bluerobotics/lumen/Lumen-Driver-X2.brd

## EAGLE design Lumen-Driver-X2.brd (2020-04-01)

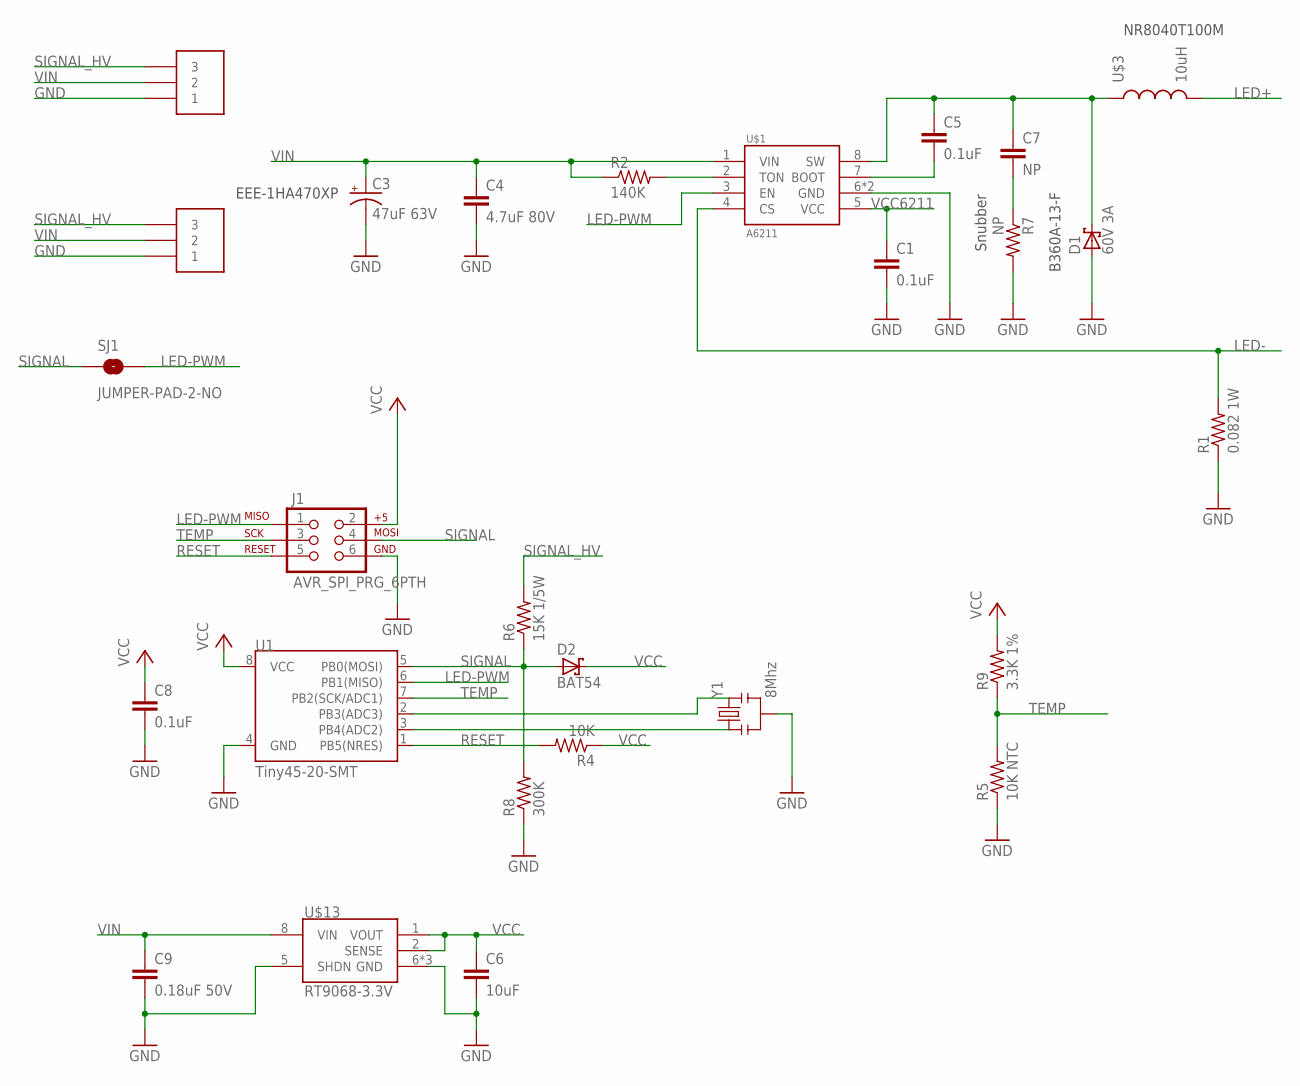
[picture p3: schematic Lumen-Driver-X2.sch]

Parts:
C1, C5, C8: 0.1uF; C0402
C3: 47uF 63V; PANASONIC_D
C4: 4.7uF 80V; C1210
C6: 10uF; C0603
C7: NP; C0603
C9: 0.18uF 50V; C0805
D1: 60V 3A; SMA
D2: BAT54; SOD523
J1: AVR_SPI_PRG_6PTH; 2X3
R1: 0.082 1W; R2512
R2: 140K; R0402
R4: 10K; R0402
R5: 10K NTC; R0603
R6: 15K 1/5W; R0402
R7: NP; R1206
R8: 300K; R0402
R9: 3.3K 1%; R0402
SJ1: JUMPER-PAD-2-NO; PAD-JUMPER-2-NO_NO_SILK
U1: Tiny45-20-SMT; SO08-EIAJ
U$1: A6211; SOIC8N-LJ
U$3: 10uH; INDUCTOR-8040
U$11, U$12: 009176003032006; AVX-9176-3POS
U$13: RT9068-3.3V; SOIC8N-LJ
Y1: 8Mhz; RESONATOR-SMD

Connections:
GND: C1.2, C3.-, C4.2, C6.2, C8.2, C9.2, D1.A, J1.6, R1.1, R5.1, R7.2, R8.1, U1.4 (GND), U$1.6 (GND), U$1.PAD (GND), U$11.1, U$12.1, U$13.5 (SHDN), U$13.6 (GND), U$13.7 (GND), U$13.PAD (GND), Y1.2
LED+: U$3.P$2 (2)
LED-: R1.2, U$1.4 (CS)
LED-PWM: J1.1, SJ1.2, U1.6 (PB1(MISO)), U$1.3 (EN)
unnamed: R2.2, U$1.2 (TON)
unnamed: C7.2, R7.1
unnamed: C5.2, U$1.7 (BOOT)
unnamed: C5.1, C7.1, D1.C, U$1.8 (SW), U$3.P$1 (1)
unnamed: U1.3 (PB4(ADC2)), Y1.1
unnamed: U1.2 (PB3(ADC3)), Y1.3
RESET: J1.5, R4.2, U1.1 (PB5(NRES))
SIGNAL: D2.A, J1.4, R6.1, R8.2, SJ1.1, U1.5 (PB0(MOSI))
SIGNAL_HV: R6.2, U$11.3, U$12.3
TEMP: J1.3, R5.2, R9.1, U1.7 (PB2(SCK/ADC1))
VCC: C6.1, C8.1, D2.C, J1.2, R4.1, R9.2, U1.8 (VCC), U$13.1 (VOUT), U$13.2 (SENSE)
VCC6211: C1.1, U$1.5 (VCC)
VIN: C3.+, C4.1, C9.1, R2.1, U$1.1 (VIN), U$11.2, U$12.2, U$13.8 (VIN)

Notes on the sheet:
NR8040T100M
B360A-13-F
Snubber
EEE-1HA470XP

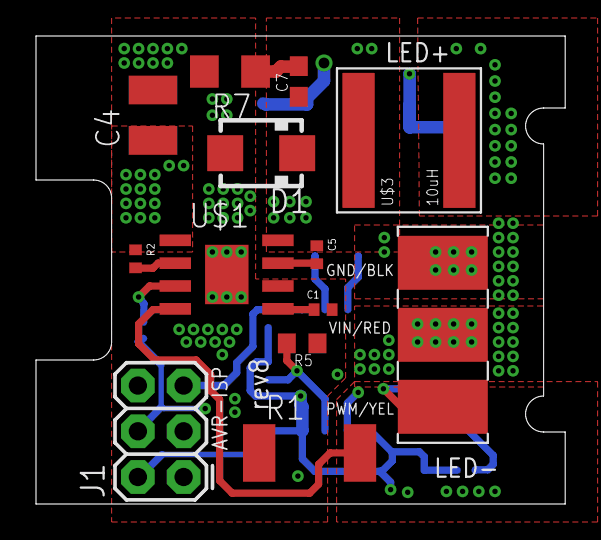
[picture p4: board Lumen-Driver-X2.brd from above]

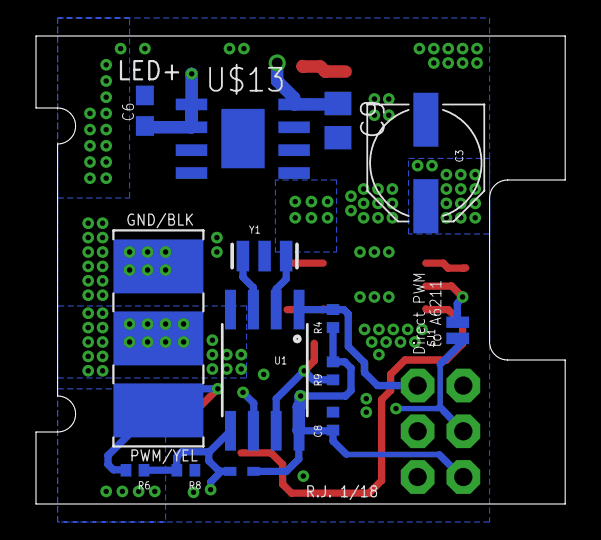
[picture p5: board Lumen-Driver-X2.brd from below]

Board: 4 copper layers, 29.4 x 26.0 mm, 27 parts (14 on the bottom side), 16 nets.
