bluerobotics/lumen/(commit log)

2015-11-24 Added starter file for schematic.
    [Lumen.sch]
2015-12-06 Added main components to schematic and wired.
    [Lumen.sch]
2015-12-06 Added thermistor.
    [Lumen.sch]
2015-12-09 Added completed board layout and made some changes to the schematic. Nearly ready for prototype.
    [Lumen.brd, Lumen.sch]
2015-12-12 Fixed a lot of little things. Added regulator back into the design. Upgrade capacitor voltage ratings.
    [Lumen.brd, Lumen.sch]
2015-12-13 Add first revision of the software. Arduino compatible because it's so easy and took 10 minutes to write. This is totally untested because the hardware does not yet exist.
2015-12-14 Fixed some layout issues per John's suggestion. Added pads for a snubber that will probably not be populated.
    [Lumen.brd, Lumen.sch]
2015-12-15 More updates based on J.N. comments. Ready to order I believe.
    [Lumen.brd, Lumen.sch]
2015-12-15 Minor update to markings for clarity.
    [Lumen.brd]
2015-12-15 Fixed two minor issues in the layout with ground per J.N. suggestion. Ordering a prototype tomorrow.
    [Lumen.brd]
2016-01-25 Added thermistor curve calculation program for Matlab/Octave.
2016-01-25 Updates to Arduino program based on testing and further study.
2016-02-01 Adjusted signal pull-down for 3.3V compatibility.
    [Lumen.brd, Lumen.sch]
2016-02-10 Added PDF schematic.
2016-02-11 Change LED PWM frequency to 3900 Hz to avoid conflict with low frame-rate cameras
    [Lumen-Arduino.ino]
2016-02-19 Adjustments for 2 oz copper boards.
2016-03-01 Update temperature values.
2016-03-02 Rearranged boards for manufacturability. Changed 0402 footprint.
    [Lumen.brd, Lumen.sch]
2016-04-06 Small updates for schematic and board.
    [Lumen.brd, Lumen.sch]
2016-04-21 Rewrite pulse function to be smart and handle noisy low-voltage signals like Pixhawk.
2016-05-23 Minor update to rev4 with larger solder holes for capacitor and silkscreen changes.
    [Lumen.brd, Lumen.sch]
2016-05-28 Minor layout updates for new production order.
    [Lumen.brd, Lumen.sch]
2016-08-25 Make signal input more noise resistant.
    [Lumen-Arduino.ino]
2018-01-06 Rev6 as produced with IDC connector.
    [Lumen.brd, Lumen.sch]
2018-02-28 Re-layout board for new size. In progress.
    [Lumen.brd, Lumen.sch]
2018-04-25 Updated R2 design. Ordered and tested.
    [Lumen-Driver-X2.brd, Lumen-Driver-X2.sch, Lumen-LED-X2.brd, Lumen-LED-X2.sch]
2018-06-08 Minor updates.
    [Lumen.brd, Lumen.sch]
2018-06-29 updated driver.
    [Lumen-Driver-X2.brd]
2018-06-29 Use hardware timers, interrupts for PWM input/output
2018-06-29 Increase timer 0 speed for better resolution
2018-06-29 Replace temp PID with P controller
    [Lumen-Arduino.ino]
2018-06-29 Prevent interrupts from interrupting volatile multi-byte values
    [Lumen-Arduino.ino]
2018-06-29 Filter and discretize input
2018-06-29 Fix millis() overflow bug
    [Lumen-Arduino.ino]
2018-06-29 Use sliding hysteresis for temperature control
2020-04-01 Update PDF schematic.
